yudai0804/cat-gpt/readme.md

# cat-gpt

# doc

[uml](./doc/uml.md)  
[tcp-protocol](./doc/tcp-protocol.md)  
[mcu](./doc/mcu.md)
