yudai0804/cat-gpt/(list of files, drawings)

Other design files:
pcb/v1.1/rat_board.dsn
