yudai0804/cat-gpt/pcb/v1.1/rat_board.kicad_pcb

## KiCad design pcb/v1.1/rat_board.kicad_pcb (2024-02-25)

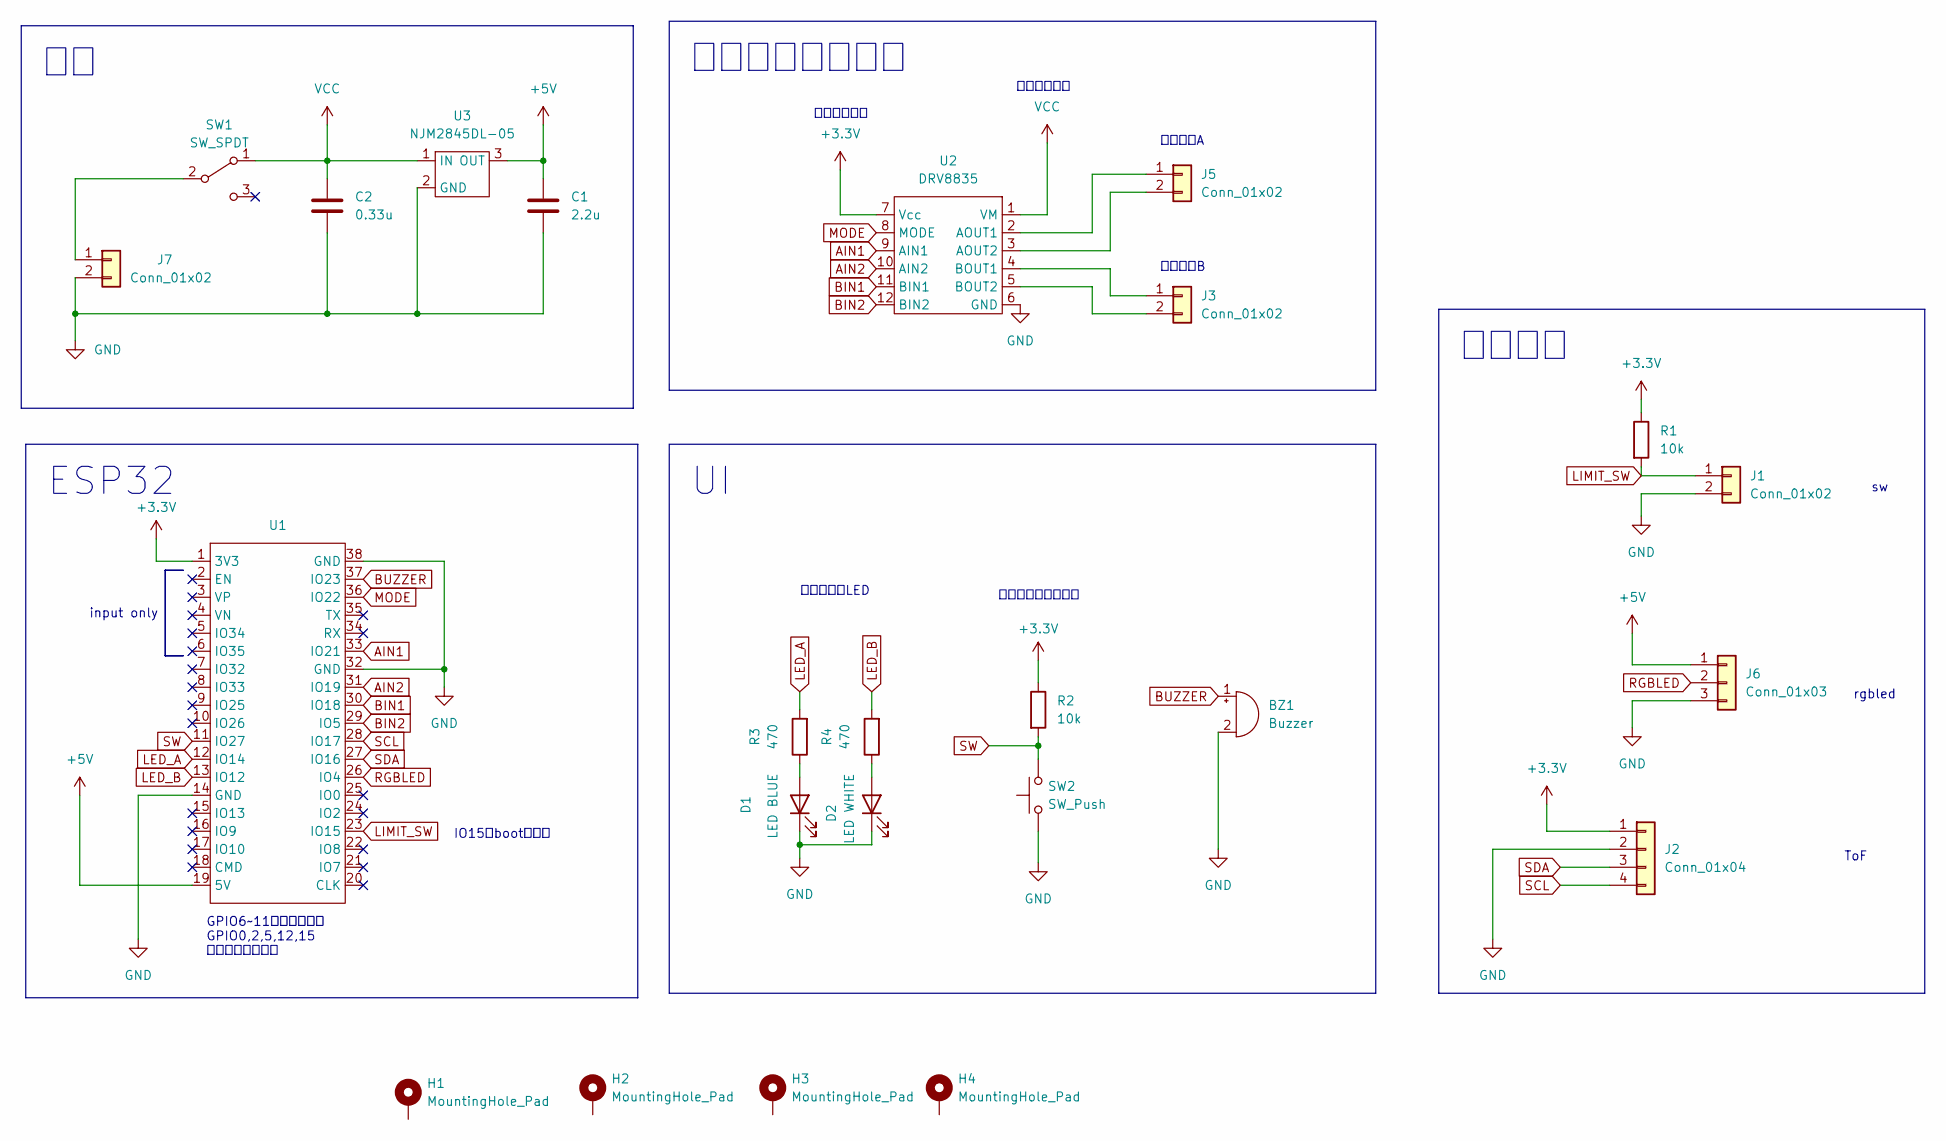
[picture p7: schematic rat_board.kicad_sch]

Parts:
BZ1: Buzzer; PKM22EPP-40
C1: 2.2u; C_Disc_D7.0mm_W2.5mm_P5.00mm
C2: 0.33u; C_Disc_D7.0mm_W2.5mm_P5.00mm
D1: LED BLUE; LED_D5.0mm
D2: LED WHITE; LED_D5.0mm
H1, H2, H3, H4: MountingHole_Pad; MountingHole_3.2mm_M3_Pad
J1, J3, J5, J7: Conn_01x02; JST_XH_B2B-XH-A_1x02_P2.50mm_Vertical
J2: Conn_01x04; JST_XH_B4B-XH-A_1x04_P2.50mm_Vertical
J6: Conn_01x03; JST_XH_B3B-XH-A_1x03_P2.50mm_Vertical
R1, R2: 10k; R_Axial_DIN0207_L6.3mm_D2.5mm_P7.62mm_Horizontal
R3, R4: 470; R_Axial_DIN0207_L6.3mm_D2.5mm_P7.62mm_Horizontal
SW1: SW_SPDT; switch
SW2: SW_Push; tact_switch
U1: ESP32
U2: DRV8835
U3: NJM2845DL-05; NJM2845

Connections:
+3.3V: J2.1, R1.1, R2.1, U1.1 (3V3), U2.7 (Vcc)
+5V: C1.1, J6.1, U1.19 (5V), U3.3 (OUT)
AIN1: U1.33 (IO21), U2.9 (AIN1)
AIN2: U1.31 (IO19), U2.10 (AIN2)
BIN1: U1.30 (IO18), U2.11 (BIN1)
BIN2: U1.29 (IO5), U2.12 (BIN2)
BUZZER: BZ1.1 (-), U1.37 (IO23)
GND: BZ1.2 (+), C1.2, C2.1, D1.1 (K), D2.1 (K), J1.2, J2.2, J6.3, J7.2, SW2.1, U1.14 (GND), U1.32 (GND), U1.38 (GND), U2.6 (GND), U3.2 (GND)
LED_A: R3.2, U1.12 (IO14)
LED_B: R4.2, U1.13 (IO12)
LIMIT_SW: J1.1, R1.2, U1.23 (IO15)
MODE: U1.36 (IO22), U2.8 (MODE)
unnamed: D1.2 (A), R3.1
unnamed: D2.2 (A), R4.1
unnamed: J3.1, U2.4 (BOUT1)
unnamed: J3.2, U2.5 (BOUT2)
unnamed: J5.1, U2.2 (AOUT1)
unnamed: J5.2, U2.3 (AOUT2)
unnamed: J7.1, SW1.2 (B)
RGBLED: J6.2, U1.26 (IO4)
SCL: J2.4, U1.28 (IO17)
SDA: J2.3, U1.27 (IO16)
SW: R2.2, SW2.2, U1.11 (IO27)
VCC: C2.2, SW1.1 (A), U2.1 (VM), U3.1 (IN)

Notes on the sheet:
モータードライバ
ESP32
コネクタ
ToF
ロジック電源
rgbled
デバッグ用スイッチ
モーターB
モーター電源
input only
IO15はbootと共有
デバッグ用LED
GPIO6~11まで使用不可 GPIO0,2,5,12,15 を使うのは非推奨
モーターA

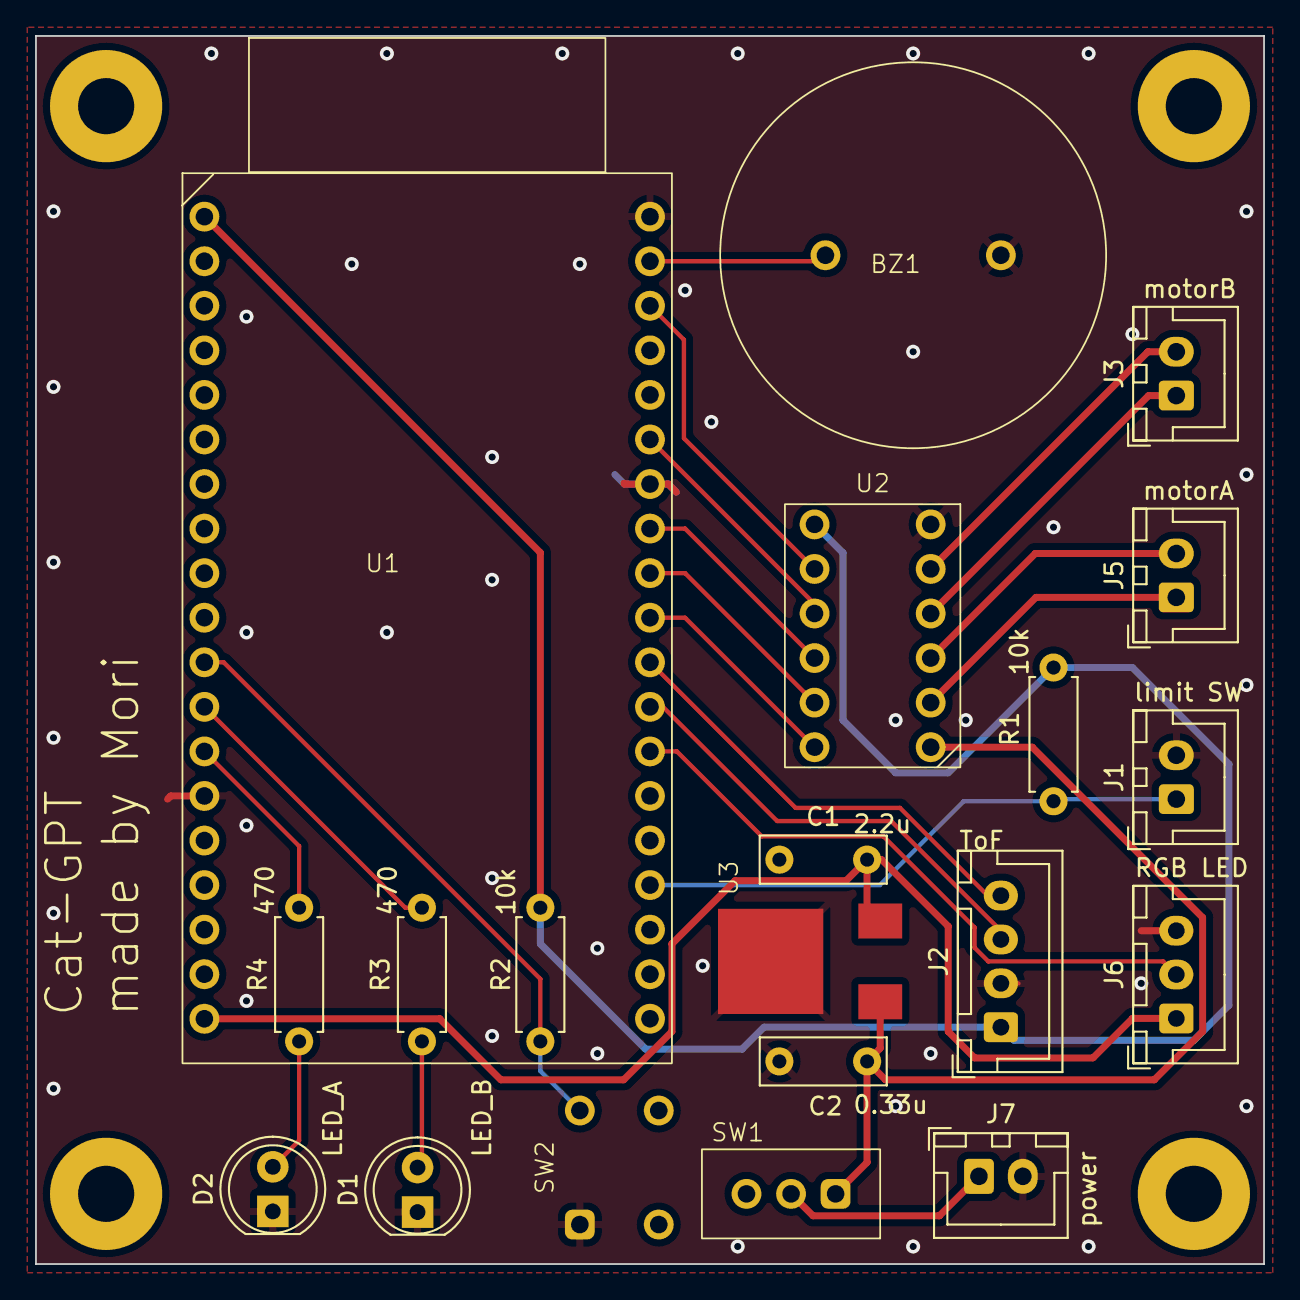
[picture p8: board pcb/v1.1/rat_board.kicad_pcb from above]

Board: 2 copper layers, 70.0 x 70.0 mm, 24 parts (0 on the bottom side), 24 nets.
