yudai0804/cat-gpt/pcb/v1.0/rat_board.kicad_pcb

## KiCad design pcb/v1.0/rat_board.kicad_pcb (2024-02-25, an earlier design)

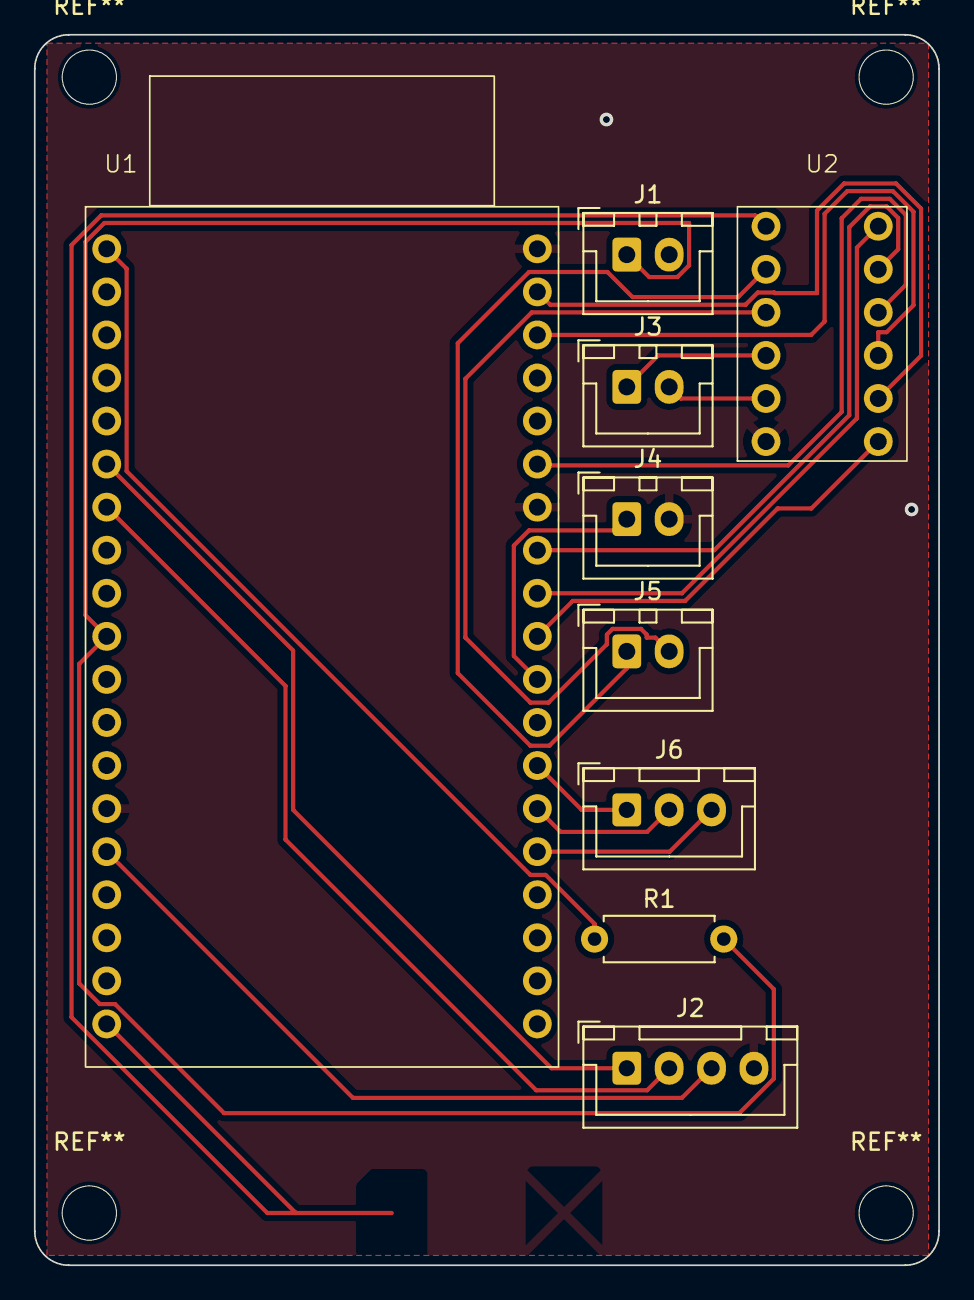
[picture p9: board pcb/v1.0/rat_board.kicad_pcb from above]

Board: 2 copper layers, 53.3 x 72.6 mm, 9 parts (0 on the bottom side), 21 nets.

Parts:
J1, J3, J4, J5: Conn_01x02; JST_XH_B2B-XH-A_1x02_P2.50mm_Vertical
J2: Conn_01x04; JST_XH_B4B-XH-A_1x04_P2.50mm_Vertical
J6: Conn_01x03; JST_XH_B3B-XH-A_1x03_P2.50mm_Vertical
R1: 10k; R_Axial_DIN0207_L6.3mm_D2.5mm_P7.62mm_Horizontal
U1: ESP32
U2: DRV8835

Connections:
3.3V-1: J2.3, U1.15 (IO13)
3.3V-2: U1.29 (IO5), U2.7 (Vcc)
+6V: U1.19 (5V), U2.1 (VM)
AIN1: U1.36 (IO22), U2.9 (AIN1)
AIN2: U1.33 (IO21), U2.10 (AIN2)
BIN1: U1.31 (IO19), U2.11 (BIN1)
BIN2: U1.30 (IO18), U2.12 (BIN2)
GND: J1.2, J2.4, J4.2, U1.14 (GND), U1.32 (GND), U1.38 (GND), U2.6 (GND)
MODE: U1.37 (IO23), U2.8 (MODE)
unnamed: J1.1, R1.2, U1.10 (IO26)
unnamed: J3.1, U2.4 (BOUT1)
unnamed: J3.2, U2.5 (BOUT2)
unnamed: J4.1, U1.28 (IO17)
unnamed: J5.1, U2.2 (AOUT1)
unnamed: J5.2, U2.3 (AOUT2)
unnamed: J6.1, U1.26 (IO4)
unnamed: J6.2, U1.25 (IO0)
unnamed: J6.3, U1.24 (IO2)
unnamed: R1.1, U1.1 (3V3)
SCL: J2.1, U1.6 (IO35)
SDA: J2.2, U1.7 (IO32)
