yudai0804/cat-gpt/(threads)

Thread 4 (2024-02-24):

ファイル名変えると動かなくなる。

yudai0804, 2024-02-24:
具体的にはfeeder_boardのrat.hとかをfeeder.hとかに変えると動かなくなる。
ソートしたときにmain.cppより後に来る名前じゃないと何故かうまく行かないというのまではわかった。
名前の順番が関係しそうなものとして、
オブジェクトファイルの生成
リンカのリンク動作
が関係そうだなと思ってる。

ただ、普通に考えて、オブジェクトファイルを生成する順番は関係ないはずなので、リンカがリンクを行うときに何か問題があるのかなと予想。

今は急ぎなので、ファイル名をrat.hとすることで対応
