yudai0804/cat-gpt/mcu/feeder_board/src/rat.h

/**
 * @file feeder.h
 * @brief
 */

#pragma once

#include "communication/communication.h"
#include "communication/information.h"
#include "rat_hardware.h"

extern communication::Communication com;
extern communication::Information information;
extern Hardware hardware;
