yudai0804/cat-gpt/(commit log)

2023-12-25 feat: drv8835のコードをとりあえず書いた
2023-12-27 feat: drv8835に回転方向を選択する機能を追加
2024-01-01 fix: 変数の初期値を設定
2024-01-02 feat: timer classを実装
2024-01-02 新しいLEDの実装ちゃんと動いた
2024-01-02 feat: blinkをfrequencyとintervalの両方に対応
2024-01-02 feat: switchも新しいtimerに対応
2024-01-02 doc: readmeにピンアサイン書いた
2024-01-02 buzzer動いた
2024-01-02 モタドラのフットプリント間違ってて泣いちゃった。フットプリント間違ってたので動作確認も取れなかった :poop:
2024-01-02 feat: state_machineクラスを実装した
2024-01-03 fix: state_machine.hからnext_stateを削除
2024-01-03 doc: stateの粒度に関する内容を記述
2024-01-03 doc: umlでstate_machine図を描いた
2024-01-03 doc: umlの画像を出力した
2024-01-03 StateMachineクラスの実装が完了
2024-01-04 fix: State構造体で保持する関数をstd::functionから関数ポインタに変更
2024-01-04 fix: 相互にincludeしあっていたのを解消
2024-01-04 feat: trapezoidクラスを追加
2024-01-04 feat: TwoWheelクラスを実装
2024-01-04 feat: Ratクラスにハードウェアに関する処理を書いた
2024-01-04 fix: rat.hのディレクトリを変更
2024-01-04 feat: StateMachineの実装が美しくなった！！！ :tada:
2024-01-05 doc: エラーについて考えるの大変だからやめた :fire:
2024-01-05 doc: IdleステートにWaitForConnectionを追加
2024-01-05 fix: umlでの変更内容をソースコードに反映
2024-01-05 feat: Informationクラスを追加
2024-01-05 fix: ファイル分割
2024-01-05 fix: コンパイルが通らなかったので修正
2024-01-06 feat: WifiTCPClientクラスを追加
2024-01-06 style: WifiTCPClientにコメントを追加
2024-01-06 fix: ステートを保持する配列をvectorにした
2024-01-06 doc: manual stateを追加
2024-01-07 doc: add sequence図
2024-01-07 doc: muc-protocolについてまとめた
2024-01-07 doc: いろんなところに情報が散らばっていたので整理
2024-01-07 doc: tcp-protocolに欠陥があったので、大幅に変更した
2024-01-07 fix: 送信時にstopを有効にするか選択できるようにした
2024-01-07 fix: timerクラスを動的確保することにした
2024-01-07 fix: timerクラスの修正をLEDクラスに反映。正常に動作したので、これから他のクラスにも反映する。
2024-01-07 fix: timerクラスの修正の反映完了
2024-01-08 fix: StateMachineクラスにcallbackを追加
2024-01-08 style: clang-formatの設定を変更
2024-01-08 fix: StateMachineクラスにCallback用setterを追加
2024-01-08 feat:固定長queueを実装
2024-01-08 fix: getterを追加
2024-01-08 feat: Bufferクラスとかいう謎クラス作った
2024-01-08 WifiTCPClientクラスの動作確認を行った
2024-01-08 doc: private_information.hの説明を追加
2024-01-08 fix: ChangeStateを追加
2024-01-10 feat: RatCommunicationを追加
2024-01-10 fix: 公開する必要がないものをpublicからprivateに変更
2024-01-10 feat: timer20msを追加
2024-01-15 fix: いろいろ修正、モーター回った
2024-01-15 fix: モーターがdisableになってた
2024-01-22 change: 通信関係のコードを共通ライブラリに追加
2024-01-22 update: いろいろ変更
2024-01-23 fix: state_machine周りを改良
2024-01-23 fix: enable_printf(is_printf)が引数の伝搬を起こしていたので削除
2024-01-23 style: コメントを追加
2024-01-30 wip: tcp_server.jsを実装中
2024-01-31 tcp_serverをちょっとだけ実装
2024-02-05 StateInformationの送受信に成功
2024-02-05 ESP32-nodejs間で通信できた
2024-02-05 changeStateちゃんと動いてそう
2024-02-05 状態遷移用タスクを追加
2024-02-05 動いてそうで動いてない
2024-02-06 requestChangeStateちゃんと動くようになった
2024-02-06 NoConnectのときにrestoreできるようにした
2024-02-06 ackの処理実装した。動くかはしらない
2024-02-13 よくわかんないけど、Ackちゃんと動いたっぽい
2024-02-13 manual moveに対応
2024-02-13 ピンアサイン間違ってて悲しい
2024-02-23 feat: ログ周りを見やすくした
2024-02-23 よさそうだ
2024-02-24 feat: feederを追加、あとちょっとだけリファクタ
2024-02-24 なんか動かなかったので、動くようにした。原因は不明
2024-02-24 ファイル名を変えると動かなくなる。
    リンクの順番が影響しているのかの思っている。
    オブジェクトファイルを生成する順番はファイル名関係ないはずだし。
2024-02-25 feat: index.html書いた。これから通信周りの実装
2024-02-25 http postできてるっぽい
2024-02-25 timeout追加
2024-02-25 とりあえず動いた！
2024-02-25 feat: スマホ対応
2024-02-25 森先輩が作った基板データをリポジトリに追加
    [rat_board-B_Cu.gbl, rat_board-B_Mask.gbs, rat_board-B_Silkscreen.gbo, rat_board-Edge_Cuts.gm1, rat_board-F_Cu.gtl, rat_board-F_Mask.gts, rat_board-F_Silkscreen.gto, rat_board.drl]
